thiasotiks/Pure-Sine-Wave-Inverter/README.md

# Pure-Sine-Wave-Inverter    
This repository includes codes for pure sine wave inverter @ 50 Hz, 220 V
It also contains the PCB design files in a seperate zip file
