thiasotiks/Pure-Sine-Wave-Inverter/EAGLE-Project-Files/Inverter.brd

## EAGLE design EAGLE-Project-Files/Inverter.brd (2021-11-11)

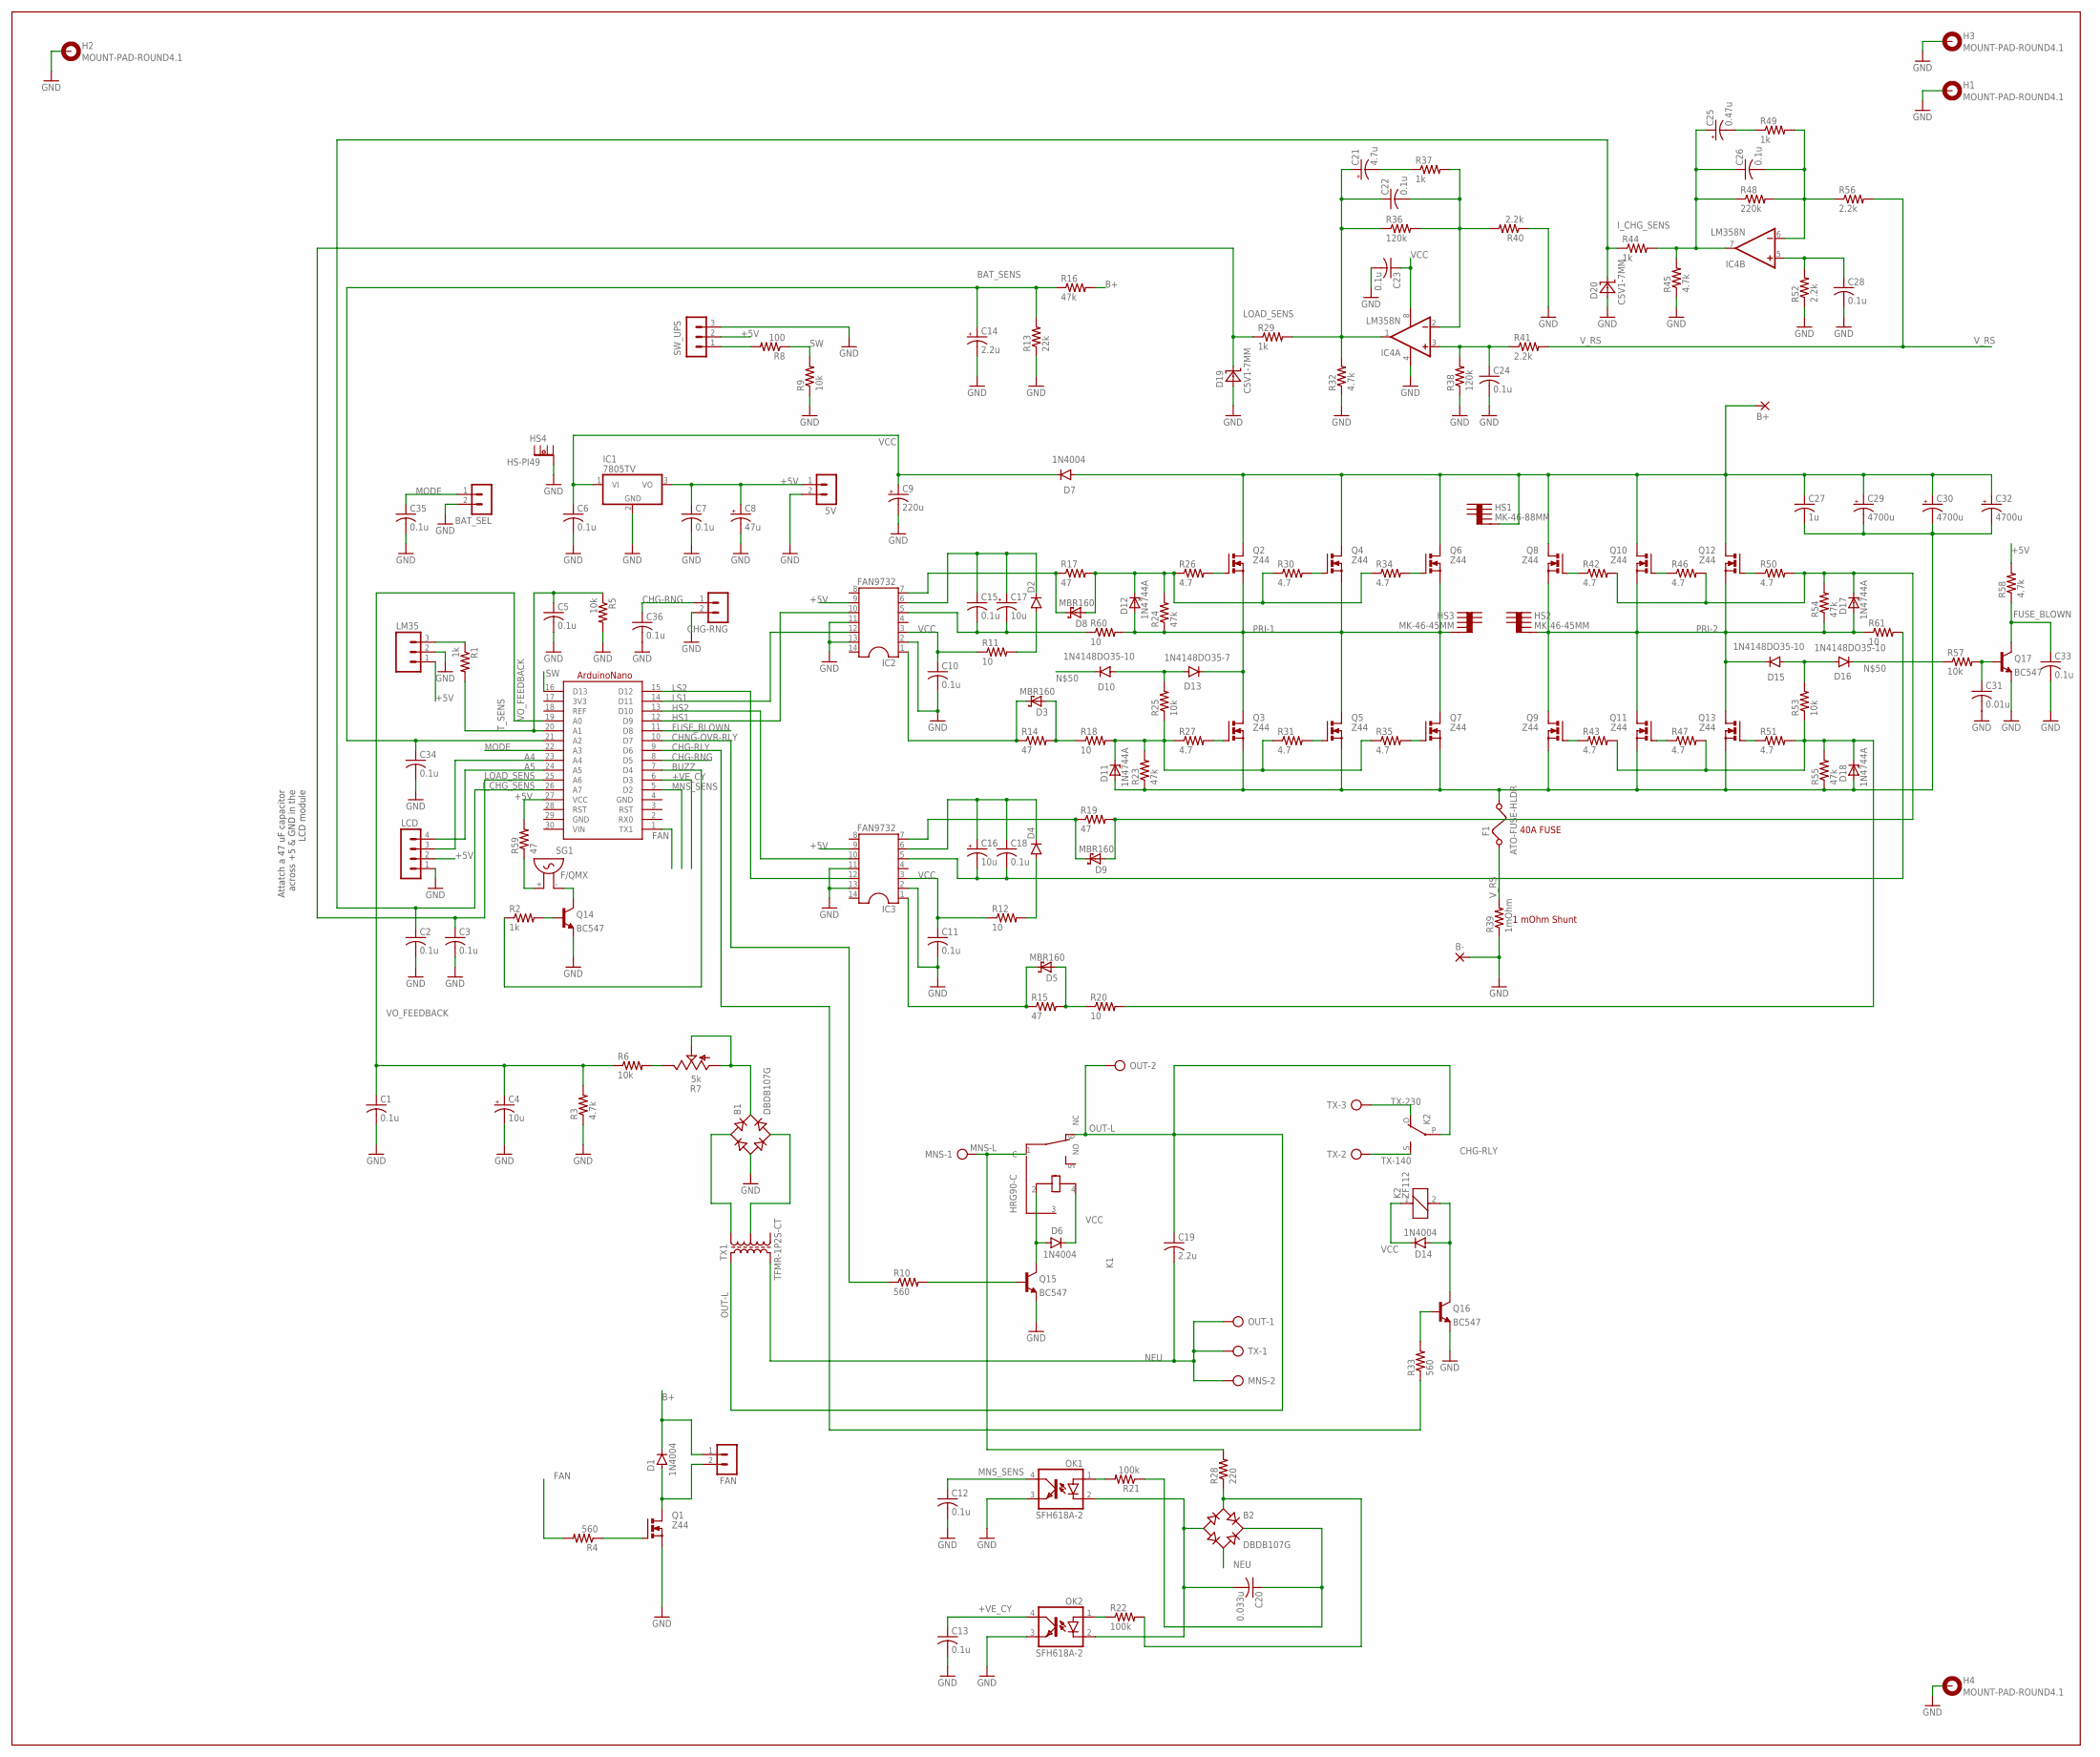
[picture p1: schematic Inverter.sch]

Parts:
5V: MA02-1
A1: ARDUINONANO-MIN-TXT; ARDUINONANO-MINIMUM-TXT
B1, B2: DBDB107G; DB
B+: 3,17/1,1
B-: 3,17/1,1
BAT_SEL: MA02-1
C1, C2, C3, C5, C6, C7, C10, C11, C12, C13, C15, C18, C22, C23, C24, C26, C28, C33, C34, C35, C36: 0.1u; C025-025X050
C4, C16, C17: 10u; E2,5-6E
C8: 47u; E2,5-6E
C9: 220u; E2,5-6E
C14: 2.2u; E2,5-6
C19: 2.2u; C230-85X245
C20: 0.033u; C050-025X075
C21: 4.7u; E2,5-6
C25: 0.47u; E2,5-6
C27: 1u; C225-113X268
C29, C30, C32: 4700u; EB20D
C31: 0.01u; C025-025X050
CHG-RNG: MA02-1
D1, D6, D7, D14: 1N4004; DO41-10
D2, D4, D10, D15, D16: 1N4148DO35-10; DO35-10
D3, D5, D8, D9: MBR160; DO41-10
D11, D12, D17, D18: 1N4744A; DO41Z10
D13: 1N4148DO35-7; DO35-7
D19, D20: C5V1-7MM; DO35-7
F1: ATO-FUSE-HLDR; ATO-FUSE-HOLDER
FAN: MA02-1
H1, H2, H3, H4: MOUNT-PAD-ROUND4.1; 4,1-PAD
HS1: MK-46-88MM
HS2, HS3: MK-46-45MM
HS4: HS-PI49; PI49-20MM
IC1: 7805TV; TO220V
IC2, IC3: FAN9732; SOCKET-14
IC4: LM358N; DIL08
K1: HRG90-C; T90-C
K2: ZF112
LCD: MA04-1
LM35: MA03; 03P
MNS: AK300/2
OK1, OK2: SFH618A-2; DIP4
OUT: AK300/2
Q1, Q2, Q3, Q4, Q5, Q6, Q7, Q8, Q9, Q10, Q11, Q12, Q13: Z44; TO220BV
Q14, Q15, Q16, Q17: BC547; TO92_LIN
R1, R2, R29, R37, R44, R49: 1k; 0207/10
R3, R32, R45, R58: 4.7k; 0207/10
R4, R10, R33: 560; 0207/10
R5, R6, R9, R25, R53, R57: 10k; 0207/10
R7: 5k; CA6V
R8: 100; 0207/10
R11, R12, R18, R20, R60, R61: 10; 0207/10
R13: 22k; 0207/10
R14, R15, R17, R19, R59: 47; 0207/10
R16, R23, R24, R54, R55: 47k; 0207/10
R21: 100k; 0411V
R22: 100k; 0411/15
R26, R27, R30, R31, R34, R35, R42, R43, R46, R47, R50, R51: 4.7; 0207/10
R28: 220; 0207/10
R36, R38: 120k; 0207/10
R39: 1mOhm; SHUNT-R
R40, R41, R52, R56: 2.2k; 0207/10
R48: 220k; 0207/10
SG1: F/QMX
SW_UPS: MA03-1
TX: AK300/3
TX1: TRANSFORMER-1P2S-CT; XFMR-1S2P-CT-41X34MM

Connections:
3V3: A1.17 (3V3)
+5V: 5V.1, A1.27 (VCC), C7.1, C8.+, IC1.3 (VO), IC2.9, IC3.9, LCD.2, LM35.1, R58.2, R59.2, SW_UPS.2
+VE_CY: A1.6 (D3), C13.1, OK2.4 (COL)
A4: A1.23 (A4), LCD.3
A5: A1.24 (A5), LCD.4
B+: B+.1, C27.1, C29.+, C30.+, C32.+, D1.C, D7.A, FAN.1, HS1.1, HS1.2, Q2.D, Q4.D, Q6.D, Q8.D, Q10.D, Q12.D, R16.2
BAT_SENS: A1.21 (A2), C14.+, C34.1, R13.2, R16.1
BUZZ: A1.7 (D4), R2.1
CHG-RLY: A1.9 (D6), R33.1
CHG-RNG: A1.8 (D5), C36.1, CHG-RNG.1
CHNG-OVR-RLY: A1.10 (D7), R10.1
FAN: A1.1 (TX1), R4.2
FUSE_BLOWN: A1.11 (D8), C33.1, Q17.3 (C), R58.1
GND: 5V.2, A1.4 (GND), A1.29 (GND), B1.-, B-.1, BAT_SEL.2, C1.2, C2.2, C3.2, C4.-, C5.2, C6.2, C7.2, C8.-, C9.-, C10.2, C11.2, C12.2, C13.2, C14.-, C23.2, C24.2, C28.2, C31.2, C33.2, C34.2, C35.2, C36.2, CHG-RNG.2, D19.A, D20.A, H1.B4,1, H2.B4,1, H3.B4,1, H4.B4,1, HS4.1, HS4.2, IC1.2 (GND), IC2.2, IC2.11, IC2.13, IC3.2, IC3.11, IC3.13, IC4.4 (V-), LCD.1, LM35.2, OK1.3 (EMIT), OK2.3 (EMIT), Q1.S, Q14.1 (E), Q15.1 (E), Q16.1 (E), Q17.1 (E), R3.1, R5.2, R9.1, R13.1, R32.1, R38.1, R39.P$1 (1), R40.1, R45.1, R52.1, SW_UPS.3
HS1: A1.12 (D9), IC2.10
HS2: A1.13 (D10), IC3.10
I_CHG_SENS: A1.26 (A7), C2.1, D20.C, R44.1
LOAD_SENS: A1.25 (A6), C3.1, D19.C, R29.1
LS1: A1.14 (D11), IC2.12
LS2: A1.15 (D12), IC3.12
MNS-L: K1.1 (C), MNS.1, R28.2
MNS_SENS: A1.5 (D2), C12.1, OK1.4 (COL)
MODE: A1.22 (A3), BAT_SEL.1, C35.1
unnamed: D4.A, R12.2
unnamed: Q15.2 (B), R10.2
unnamed: C15.1, C17.+, D2.C, IC2.6
unnamed: C16.+, C18.1, D4.C, IC3.6
unnamed: Q14.3 (C), SG1.- (1)
unnamed: D8.A, D12.C, R17.2, R24.2, R26.1, R30.1, R34.1
unnamed: D2.A, R11.2
unnamed: D8.C, IC2.7, R17.1
unnamed: D3.C, IC2.1, R14.1
unnamed: D9.C, IC3.7, R19.1
unnamed: D5.C, IC3.1, R15.1
unnamed: D11.C, R18.2, R23.2, R25.1, R27.1, R31.1, R35.1
unnamed: C27.2, C29.-, C30.-, C32.-, D11.A, D18.A, F1.P$2 (2), Q3.S, Q5.S, Q7.S, Q9.S, Q11.S, Q13.S, R23.1, R55.1
unnamed: D9.A, D17.C, R19.2, R42.2, R46.2, R50.2, R54.2
unnamed: D18.C, R20.2, R43.2, R47.2, R51.2, R53.1, R55.2
unnamed: Q2.G, R26.2
unnamed: C24.1, IC4.3 (+IN), R38.2, R41.1
unnamed: B1.AC1, TX1.10
unnamed: C16.-, C18.2, IC3.5, R61.2
unnamed: LM35.3, R1.1
unnamed: B1.AC2, TX1.8
unnamed: C22.2, IC4.2 (-IN), R36.2, R37.2, R40.2
unnamed: B1.+, R7.A, R7.S
unnamed: Q14.2 (B), R2.2
unnamed: R6.2, R7.E
unnamed: Q3.G, R27.2
unnamed: C15.2, C17.-, IC2.5, R60.1
unnamed: Q1.G, R4.1
unnamed: B2.AC1, R22.2, R28.1
unnamed: D1.A, FAN.2, Q1.D
unnamed: D6.A, K1.2 (COIL2), Q15.3 (C)
unnamed: Q13.G, R51.1
unnamed: D14.A, K2.2, Q16.3 (C)
unnamed: Q16.2 (B), R33.2
unnamed: Q12.G, R50.1
unnamed: OK1.1 (A), R21.2
unnamed: OK2.1 (A), R22.1
unnamed: B2.-, C20.2, OK1.2 (C), OK2.2 (C)
unnamed: B2.+, C20.1, R21.1
unnamed: C21.+, C22.1, IC4.1 (OUT), R29.2, R32.2, R36.1
unnamed: C21.-, R37.1
unnamed: Q9.G, R43.1
unnamed: D10.A, D13.A, R25.2
unnamed: Q4.G, R30.2
unnamed: Q6.G, R34.2
unnamed: Q8.G, R42.1
unnamed: Q10.G, R46.1
unnamed: Q11.G, R47.1
unnamed: Q5.G, R31.2
unnamed: D10.C, D16.C, R57.1
unnamed: Q7.G, R35.2
unnamed: D15.A, D16.A, R53.2
unnamed: D5.A, R15.2, R20.1
unnamed: D3.A, R14.2, R18.1
unnamed: C31.1, Q17.2 (B), R57.2
unnamed: R8.2, SW_UPS.1
unnamed: C26.2, IC4.6 (-IN), R48.2, R49.2, R56.1
unnamed: C25.+, C26.1, IC4.7 (OUT), R44.2, R45.2, R48.1
unnamed: C28.1, IC4.5 (+IN), R52.2
unnamed: C25.-, R49.1
unnamed: R59.1, SG1.+ (2)
NEU: B2.AC2, C19.2, MNS.2, OUT.1, TX.1, TX1.5
OUT-L: C19.1, K1.6 (NC), K2.P, OUT.2, TX1.1
PRI-1: D12.A, D13.C, HS3.1, HS3.2, Q2.S, Q3.D, Q4.S, Q5.D, Q6.S, Q7.D, R24.1, R60.2
PRI-2: D15.C, D17.A, HS2.1, HS2.2, Q8.S, Q9.D, Q10.S, Q11.D, Q12.S, Q13.D, R54.1, R61.1
REF: A1.18 (REF)
SW: A1.16 (D13), R8.1, R9.2
TX-140: K2.S, TX.2
TX-230: K2.O, TX.3
T_SENS: A1.20 (A1), C5.1, R1.2, R5.1
VCC: C6.1, C9.+, C10.1, C11.1, C23.1, D6.C, D7.C, D14.C, IC1.1 (VI), IC2.3, IC3.3, IC4.8 (V+), K1.4 (COIL1), K2.1, R11.1, R12.1
VIN: A1.30 (VIN)
VO_FEEDBACK: A1.19 (A0), C1.1, C4.+, R3.2, R6.1
V_RS: F1.P$1 (1), R39.P$2 (2), R41.2, R56.2

Notes on the sheet:
40A FUSE
1 mOhm Shunt
Attatch a 47 uF capacitor across +5 & GND in the LCD module

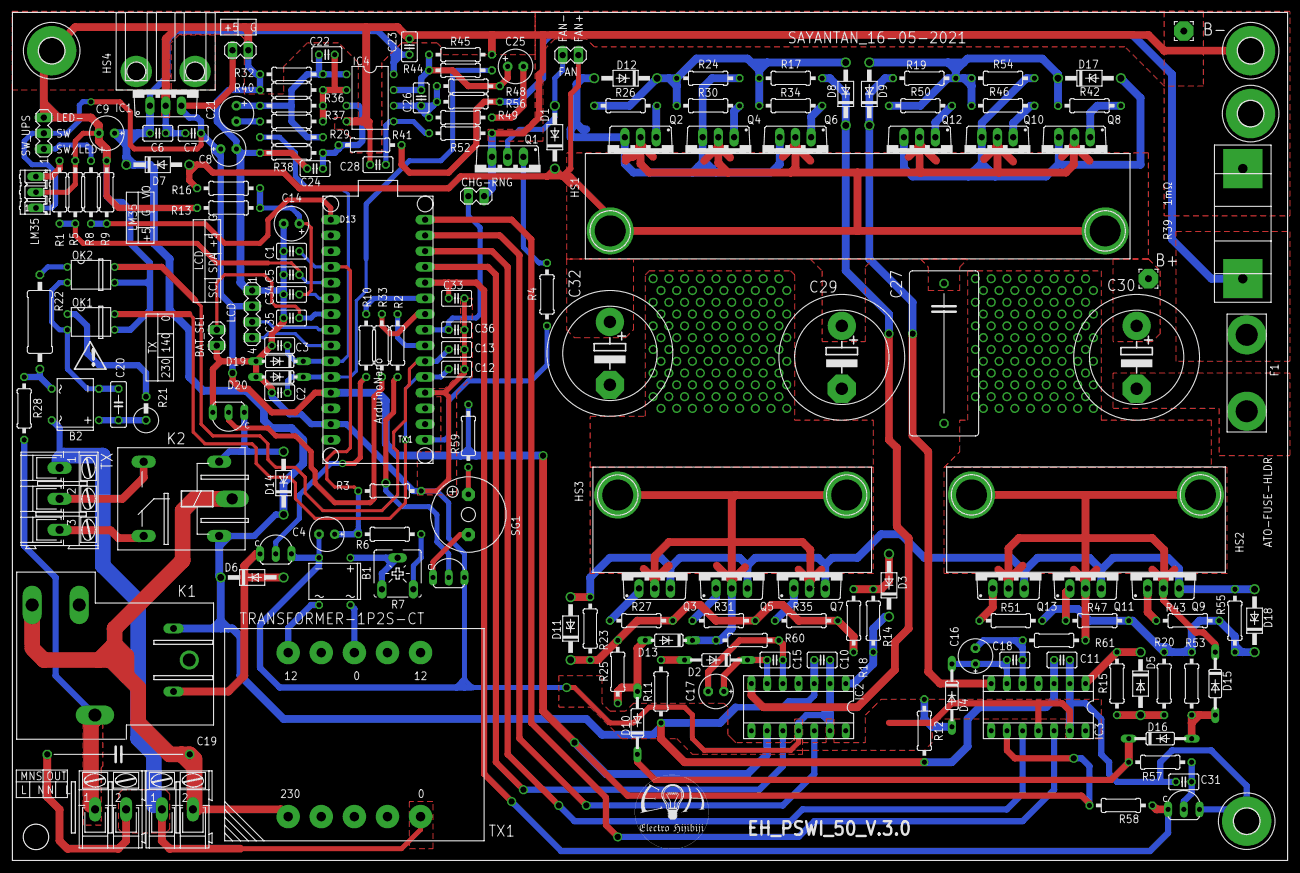
[picture p2: board Inverter.brd from above]

Board: 2 copper layers, 206.0 x 137.0 mm, 168 parts (0 on the bottom side), 94 nets.
